TalismanDesign/PocketMage_PDA/Docs/docs/guides/index.md

---
title: "Guides"
description: "Practical guides for building apps and working with PocketMage."
---

# Guides

How to build apps on PocketMageOS, use the PocketMage Library, and work through the terminal scripting flow.

::: tag "App workflow"
::: tag "Native apps"
::: tag "ELF apps"
::: tag "Scripting"

## Guides

::: grids
::: grid
::: card "Making Apps" icon:code
The app workflow, the template, and the choice between native and ELF apps.

::: button "Open" ./making-apps.md icon:arrow-right
:::
:::
::: grid
::: card "Native Apps" icon:terminal
How PocketMageOS apps are structured and wired into the OS.

::: button "Open" ./native-apps.md icon:arrow-right
:::
:::
::: grid
::: card "ELF Apps" icon:package
How third-party apps fit into the runtime loader and shared library layer.

::: button "Open" ./elf-apps.md icon:arrow-right
:::
:::
::: grid
::: card "Scripting" icon:zap
The Wrench terminal app and its examples.

::: button "Open" ../scripting/index.md icon:arrow-right
:::
:::
:::

## Best fit

::: callout tip "Pick the right page" Use **Making Apps** for the full path, **Native Apps** if you are changing the OS, **ELF Apps** if you are shipping third-party code, and **Scripting** if you want to automate from the terminal app.
:::
