TalismanDesign/PocketMage_PDA/Resources/CAD/V3.4 FDM Friendly/keysMeshed_BLANK.step

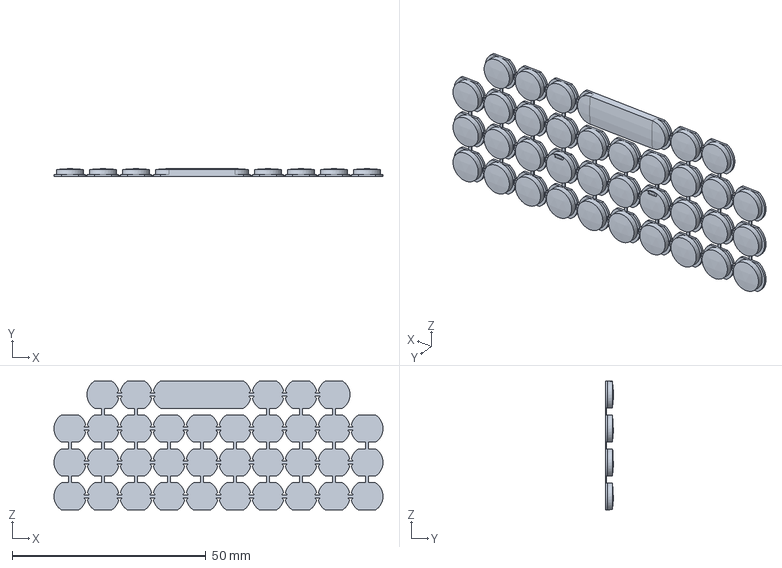
[picture p1: CAD file, 2026-09-10]
Resources/CAD/V3.4 FDM Friendly/keysMeshed_BLANK.step
85.0 x 1.97 x 33.3 mm
