TalismanDesign/PocketMage_PDA/Resources/PCB/V3.6/einkPDA_keyboard/einkPDA_keyboard.kicad_pcb

## KiCad design Resources/PCB/V3.6/einkPDA_keyboard/einkPDA_keyboard.kicad_pcb (2026-09-25)

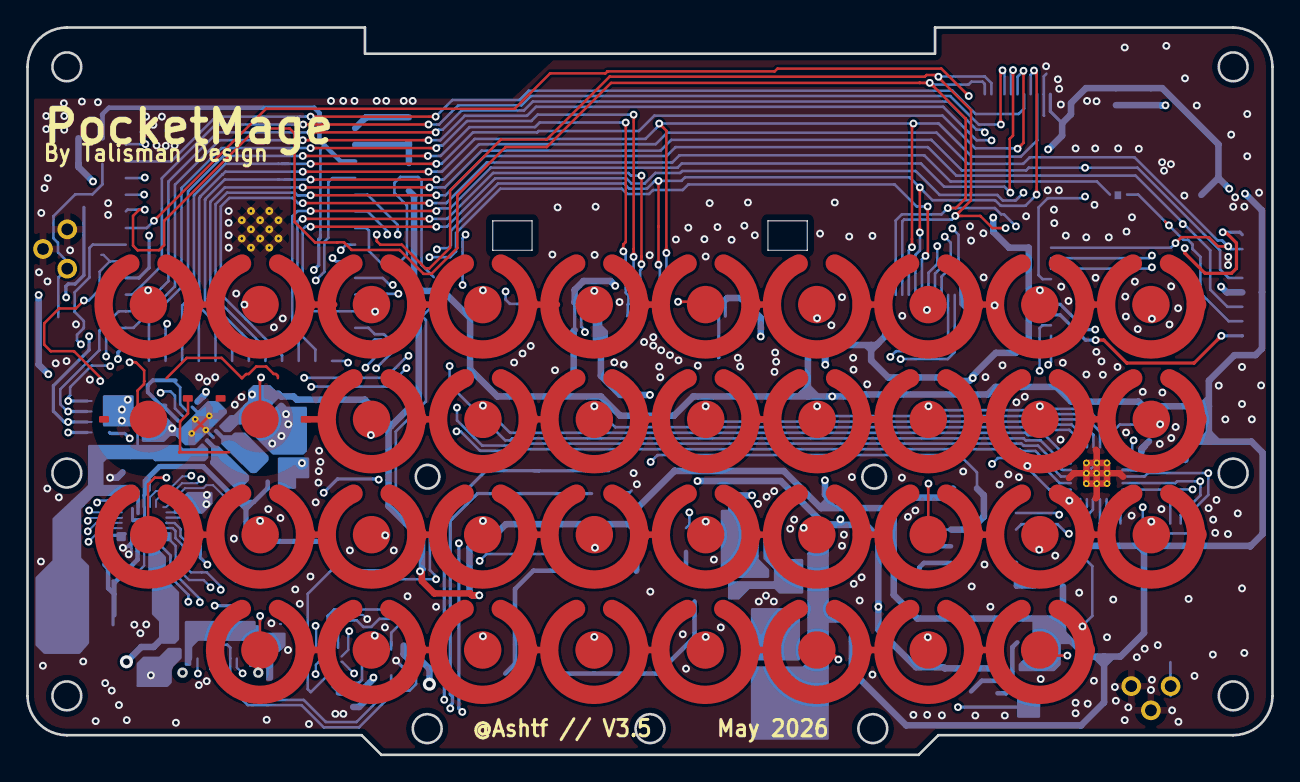
[picture p2: board einkPDA_keyboard.kicad_pcb from above]

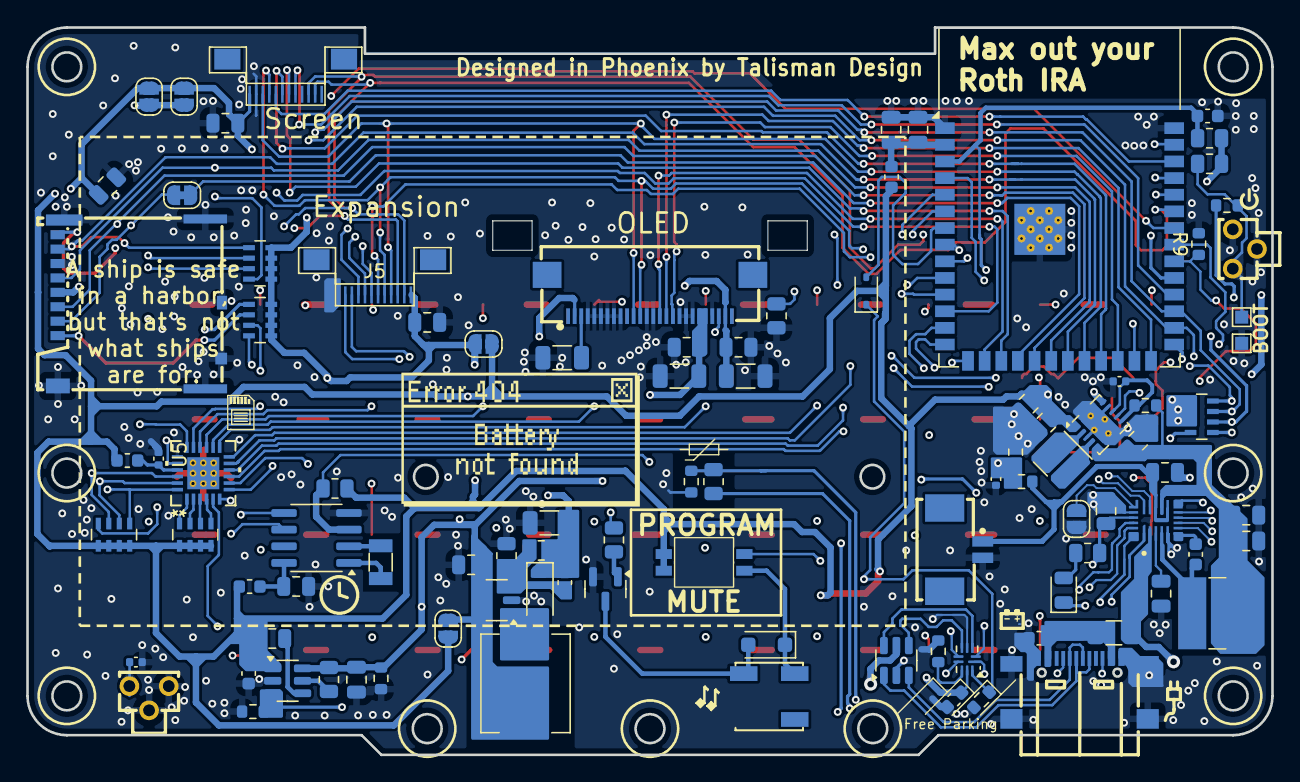
[picture p3: board einkPDA_keyboard.kicad_pcb from below]

Board: 4 copper layers, 95.0 x 55.5 mm, 136 parts (98 on the bottom side), 103 nets.

Parts:
BZ1: Buzzer; BUZ-SMD_3P_L5.0-W5.0-P3.50-TL
C1, C4, C6, C20: 1uF; C_0603_1608Metric
C2, C9: 100nF; C_0805_2012Metric
C3, C21, C22: 22uF; C_0805_2012Metric
C5: 47uF; C_0805_2012Metric
C7, C8, C19, C33: 0.1uF; C_0402_1005Metric
C10, C23, C24, C26, C28, C29, C30, C31, C32: 10uF; C_0805_2012Metric
C11: 4.7pF; C_0603_1608Metric
C12, C13, C14, C16: 4.7uF; C_1206_3216Metric
C15, C17: .1uF; C_0805_2012Metric
C18: 680pF; C_0805_2012Metric
C25: 4.7uF; C_0805_2012Metric
C27: 22nF; C_0603_1608Metric
D1: KT-0805Y; LED_0805_2012Metric
D2: MBR0530; D_SOD-123
D3: SM4007; D_SOD-123F
D5: D_Schottky; D_SOD-323
F1: SMD1206-500-6V; Fuse_1206_3216Metric
FB1, FB2, FB3: FerriteBead; L_0603_1608Metric
J1: USB_C_Receptacle_USB2.0_16P; USB-TYPE-C-SMD_TYPE-C-16P-QTWT
J2, J5: Conn_01x12_Pin; AFC01-S12FCA-00
J3: Conn_01x26_Pin; FPC-SMD_AFC24-S26FIA [DUAL-SIDE]
J4: Micro_SD_Card; TF-SMD_503398-1892
JP1: SolderJumper_2_Bridged; SolderJumper-2_P1.3mm_Bridged_RoundedPad1.0x1.5mm
JP2, JP6, JP7, JP8, JP9: SolderJumper_2_Open; SolderJumper-2_P1.3mm_Open_RoundedPad1.0x1.5mm
L1: 10uH; L_Chilisin_BMRx00060630
L2: 1uH; L_Ferrocore_DLG-0504
L3: 2.2uH; L_Wurth_WE-LQSH-3012
Q1: MMBT3904; SOT-23
R1, R14: 10K; R_0805_2012Metric
R2, R8: 100R; R_0603_1608Metric
R3: 4.7k; R_0603_1608Metric
R4: 1k; R_0603_1608Metric
R5, R15: 470R; R_0805_2012Metric
R6, R7, R9, R19: 100K; R_0603_1608Metric
R11, R16: 2k; R_0805_2012Metric
R12: 1.8M; R_0805_2012Metric
R13: 205k; R_0805_2012Metric
R17: 10k; R_0805_2012Metric
R18: 10k; R_0603_1608Metric
R20: 680k; R_0805_2012Metric
RN1, RN2, RN3, RN4, RN5: 4x10k; R_Array_Concave_4x0603
SW1, SW3, SW5, SW6, SW7, SW9, SW10, SW11, SW12, SW13, SW14, SW15, SW16, SW17, SW18, SW19, SW20, SW21, SW22, SW23, SW24, SW25, SW26, SW27, SW28, SW29, SW30, SW31, SW32, SW33, SW34, SW35, SW37, SW38, SW39, SW40: contact_pad_SINGLE
SW2: contactPad_cutoutR
SW4: SW_DIP_x02; 2X_DIP_DHN-02-V-TR
SW8: contactPad_cutoutL
SW36, SW41: YTS-C017-2B; KEY-TH_3P-L4.5-W4.5-P3.0-EH
TH1: NTC; R_0603_1608Metric
TP1, TP2: TestPoint; TestPoint_Pad_1.0x1.0mm
U1: ESP32-S3-WROOM-1-N16R2; ESP32-S3-WROOM-1
U2: USBLC6-2SC6; SOT-23-6
U3: TPS63001; Texas_DRC0010J_ThermalVias
U4: PCF8563T; SOIC-8_3.9x4.9mm_P1.27mm
U5: TCA8418RTWR; RTW24_2P45X2P45
U6: C2764211; CONN-SMD_532610271
U7: TPS61040DBV; SOT-23-5
U8: TPS22917DBV; SOT-23-6
U9: MP2722GRH-0000-Z; IC_MP2722GRH-0000-Z
U10: TS3USB30ERSWR; UQFN-10_1.4x1.8mm_P0.4mm
Y1: Crystal_32.768kHz; Crystal_SMD_3215-2Pin_3.2x1.5mm

Connections:
+3.3V: C4.2, C6.2, C18.1, C31.2, C32.2, FB1.1, FB2.2, FB3.1, JP2.2 (B), JP7.2 (B), JP8.2 (B), JP9.2 (B), R1.1, R11.2, R14.1, RN1.1 (R1.1), RN1.2 (R2.1), RN1.3 (R3.1), RN1.4 (R4.1), RN2.5 (R4.2), RN2.6 (R3.2), RN2.7 (R2.2), RN2.8 (R1.2), RN4.5 (R4.2), RN4.6 (R3.2), RN4.7 (R2.2), SW4.1, SW4.2, U3.1 (VOUT), U3.10 (FB), U8.1 (VIN), U10.9 (VCC)
+12V: C11.2, C12.1, C13.1, C15.1, D2.1 (K), J3.2, J3.25, R12.1
BAT+: C26.2, R6.1, U6.1 (BATT-), U9.12 (BATTSNS), U9.14 (BATT)
BAT_MEAS: C19.1, R6.2, R7.1, U1.4 (IO4)
BMS_INT: RN4.4 (R4.1), U1.33 (IO40), U9.8 (~INT)
BOOT: R8.1, R14.2, SW36.1, TP1.1
BUZZER: R15.1, U1.10 (IO17)
BZ_CUTOFF: BZ1.1 (+), D3.1 (K), SW4.3
E-PAPER_BUSY: J2.5, U1.30 (IO37)
E-PAPER_CS: J2.8, U1.38 (IO2)
E-PAPER_D/C: J2.7, U1.23 (IO21)
E-PAPER_RES: J2.6, U1.17 (IO9)
EN: C1.2, C33.1, R1.2, SW41.1, U1.3 (EN)
ESP_D+: U1.14 (IO20), U10.2 (D2+)
ESP_D-: U1.13 (IO19), U10.6 (D2-)
EX_A: J5.7, U1.15 (IO3)
EX_B: J5.8, U1.11 (IO18)
EX_C: J5.9, U1.34 (IO41)
GND: C1.1, C2.1, C3.1, C4.1, C5.2, C6.1, C7.2, C8.2, C9.1, C10.1, C12.2, C13.2, C14.2, C15.2, C16.2, C17.2, C19.2, C20.1, C21.1, C22.1, C23.1, C24.2, C25.2, C26.1, C28.1, C29.1, C30.1, C31.1, C32.1, C33.2, J1.A1 (GND), J1.A12 (GND), J1.S1 (SHIELD), J2.11, J3.4, J3.5, J3.6, J3.7, J3.8, J3.9, J3.13, J3.14, J3.18, J3.19, J3.20, J3.23, J4.6 (VSS), J4.9 (SHIELD), J5.12, JP6.1 (A), Q1.2 (E), R3.2, R4.2, R7.2, R9.2, R13.2, R18.2, R19.2, R20.2, SW36.2, SW36.3 (GND), SW41.2, SW41.3 (GND), TH1.2, TP2.1, U1.1 (GND), U1.40 (GND), U1.41 (GND), U2.2 (GND), U3.3 (PGND), U3.9 (GND), U3.11 (PGND), U4.4 (VSS), U5.19 (GND), U5.25 (EPAD), U6.3 (BATT+), U7.2 (GND), U8.2 (GND), U9.5 (PGND), U9.18 (AGND), U10.4 (GND)
I2C_SCL: RN1.6 (R3.2), RN4.2 (R2.1), U1.28 (IO35), U4.6 (SCL), U5.23 (SCL), U9.16 (SCL)
I2C_SCL_SWITCHED: J2.3, J5.3, RN5.7 (R2.2), U1.25 (IO48)
I2C_SDA: RN1.7 (R2.2), RN4.3 (R3.1), U1.29 (IO36), U4.5 (SDA), U5.22 (SDA), U9.15 (SDA)
I2C_SDA_SWITCHED: J2.2, J5.2, RN5.8 (R1.2), U1.35 (IO42)
IC_D+: U9.21 (D+), U10.1 (D1+)
IC_D-: U9.20 (D-), U10.7 (D1-)
KB_INT: RN1.5 (R4.2), U1.12 (IO8), U5.24 (*INT)
LOAD: R19.1, U1.31 (IO38), U8.3 (ON)
unnamed: BZ1.2 (-), D3.2 (A), Q1.3 (C)
unnamed: C20.2, F1.1, J1.A4 (VBUS), J1.A9 (VBUS)
unnamed: D1.2 (A), R16.1
unnamed: D1.1 (K), U9.11 (STAT/IB)
unnamed: D2.2 (A), L1.2, U7.1 (SW)
unnamed: D5.1 (K), R18.1, SW4.4, U10.10 (S)
unnamed: J1.A5 (CC1), U9.1 (CC1)
unnamed: J1.B5 (CC2), U9.22 (CC2)
unnamed: J1.A6 (D+), J1.B6 (D+), U2.1 (I/O1)
unnamed: J1.A7 (D-), J1.B7 (D-), U2.3 (I/O2)
unnamed: C14.1, J3.3
unnamed: J3.24, R20.1
unnamed: J4.2 (DAT3/CD), JP1.2 (B), RN3.7 (R2.2)
unnamed: JP6.2 (B), U9.17 (~RST)
unnamed: Q1.1 (B), R15.2
unnamed: RN1.8 (R1.2), U5.20 (*RESET)
unnamed: RN2.1 (R1.1), U5.4 (ROW4)
unnamed: RN2.2 (R2.1), U5.3 (ROW5)
unnamed: RN2.3 (R3.1), U5.2 (ROW6)
unnamed: RN2.4 (R4.1), U5.1 (ROW7)
unnamed: RN4.1 (R1.1), U9.9 (PG/NTC2)
unnamed: C25.1, R16.2, RN4.8 (R1.2), U9.19 (VCC)
unnamed: C2.2, C3.2, FB1.2, U1.2 (3V3)
unnamed: R8.2, U1.27 (IO0)
unnamed: C7.1, R2.1, U3.6 (EN), U3.8 (VINA)
unnamed: L3.1, U3.4 (L1)
unnamed: L3.2, U3.2 (L2)
unnamed: U4.1 (OSCI), Y1.1
unnamed: U4.2 (OSCO), Y1.2
unnamed: C9.2, FB3.2, U4.8 (VDD)
unnamed: C8.1, FB2.1, U5.21 (VCC)
unnamed: C11.1, R12.2, R13.1, U7.3 (FB)
unnamed: C18.2, U8.4 (CT)
unnamed: R5.2, U8.5 (QOD)
unnamed: C27.2, U9.6 (BST)
unnamed: R17.1, TH1.1, U9.10 (NTC1)
unnamed: C23.2, U9.3 (PMID)
unnamed: C27.1, L2.1, U9.4 (SW)
unnamed: R17.2, U9.7 (VRNTC)
unnamed: R3.1, U10.8 (~OE)
OLED_CS: J3.17, U1.24 (IO47)
OLED_D/C: J3.15, U1.16 (IO46)
OLED_RES: J3.16, U1.26 (IO45)
PWR_SAVE: R9.1, U1.32 (IO39), U3.7 (PS/SYNC)
RTC_INT: R11.1, U1.39 (IO1), U4.3 (~INT)
RX: J5.11, U1.36 (RXD0)
SD_CLK: J4.5 (CLK), RN3.8 (R1.2), U1.20 (IO12)
SD_CMD: J4.3 (CMD), RN3.6 (R3.2), U1.19 (IO11)
SD_CS: JP1.1 (A), U1.18 (IO10)
SD_D0: J4.7 (DAT0), RN3.5 (R4.2), U1.21 (IO13)
SD_D1: J4.8 (DAT1), RN5.5 (R4.2), U1.5 (IO5)
SD_D2: J4.1 (DAT2), RN5.6 (R3.2), U1.6 (IO6)
SPI_MISO_SWITCHED: J5.6, U1.9 (IO16)
SPI_MOSI_SWITCHED: J2.10, J3.11, J5.4, U1.22 (IO14)
SPI_SCK_SWITCHED: J2.9, J3.12, J5.5, U1.8 (IO15)
TX: J5.10, U1.37 (TXD0)
USB_5V: F1.2, U2.5 (VBUS), U9.2 (IN)
USB_D+: U2.6 (I/O1), U10.3 (D+)
USB_D-: U2.4 (I/O2), U10.5 (D-)
USB_SW: D5.2 (A), U1.7 (IO7)
V_LOADSWITCH: C5.1, C10.2, C16.1, C17.1, C21.2, C22.2, C24.1, J2.12, J3.21, J3.22, J4.4 (VDD), J5.1, JP2.1 (A), JP7.1 (A), JP8.1 (A), JP9.1 (A), L1.1, R4.1, R5.1, RN3.1 (R1.1), RN3.2 (R2.1), RN3.3 (R3.1), RN3.4 (R4.1), RN5.1 (R1.1), RN5.2 (R2.1), RN5.3 (R3.1), RN5.4 (R4.1), U7.4 (EN), U7.5 (VIN), U8.6 (VOUT)
V_SYS: C28.2, C29.2, C30.2, L2.2, R2.2, U3.5 (VIN), U9.13 (SYS)
col1: SW1.1, SW2.1, SW3.1, U5.9 (COL0)
col2: SW7.1, SW8.1, SW9.1, SW10.1, U5.10 (COL1)
col3: SW13.1, SW14.1, SW15.1, SW16.1, U5.11 (COL2)
col4: SW19.1, SW20.1, SW21.1, SW22.1, U5.12 (COL3)
col5: SW25.1, SW26.1, SW27.1, SW28.1, U5.13 (COL4)
col6: SW31.1, SW32.1, SW33.1, SW34.1, U5.14 (COL5)
col7: SW37.1, SW38.1, SW39.1, SW40.1, U5.15 (COL6)
col8: SW5.1, SW6.1, SW11.1, SW12.1, U5.16 (COL7)
col9: SW17.1, SW18.1, SW23.1, SW24.1, U5.17 (COL8)
col10: SW29.1, SW30.1, SW35.1, U5.18 (COL9)
row1: SW1.2, SW5.2, SW7.2, SW13.2, SW17.2, SW19.2, SW25.2, SW29.2, SW31.2, SW37.2, U5.8 (ROW0)
row2: SW2.2, SW6.2, SW8.2, SW14.2, SW18.2, SW20.2, SW26.2, SW30.2, SW32.2, SW38.2, U5.7 (ROW1)
row3: SW3.2, SW9.2, SW11.2, SW15.2, SW21.2, SW23.2, SW27.2, SW33.2, SW35.2, SW39.2, U5.6 (ROW2)
row4: SW10.2, SW12.2, SW16.2, SW22.2, SW24.2, SW28.2, SW34.2, SW40.2, U5.5 (ROW3)
