TalismanDesign/PocketMage_PDA/(commit log)

2026-09-07 Drain keyboard FIFO before deep sleep on power-event sleep path
    https://github.com/TheCodingSoldier/PocketMage_PDA/commit/0984ce4cc2e5be2f68b297a9f43df7be8a703842
2026-09-22 It works!!!
    [partitions_OTA_APP.csv]
2026-09-25 Update PCBs
    [bom.csv, einkPDA_keyboard.kicad_pcb, positions.csv]
2026-09-29 Drop OTA-app model for the in-process ELF loader
    [partitions.csv, partitions_4APP.csv]
2026-10-12 switch to submodule
